ladapn/wallckr-z2/kicad/motherboard/motherboard.kicad_pcb

## KiCad design kicad/motherboard/motherboard.kicad_pcb (2026-10-02)

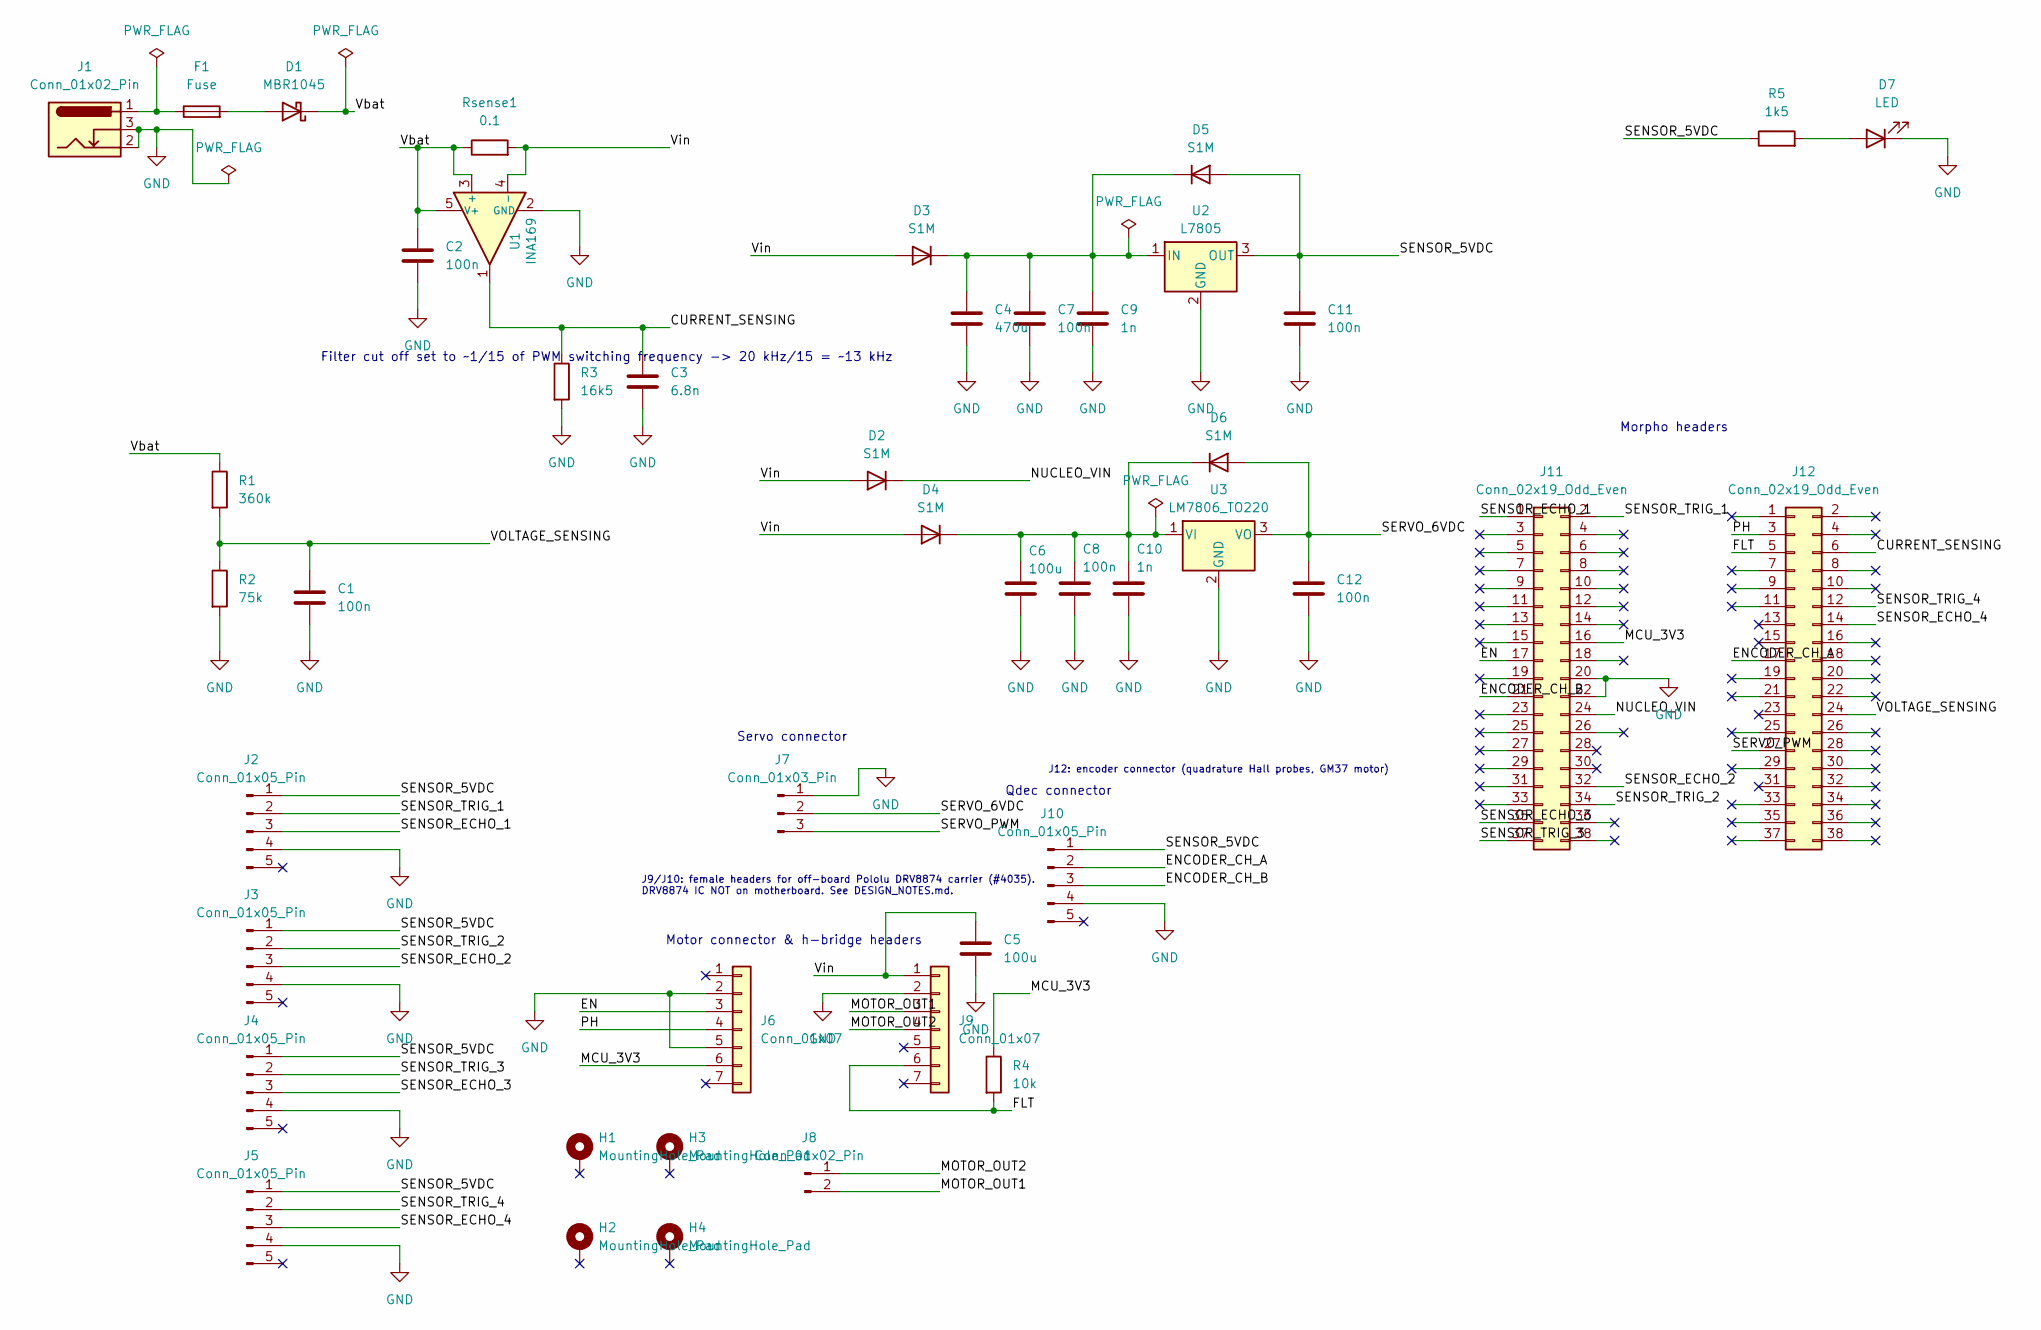
[picture p1: schematic motherboard.kicad_sch]

Parts:
C1, C2, C7, C8, C11, C12: 100n; C_0805_2012Metric_Pad1.18x1.45mm_HandSolder
C3: 6.8n; C_0805_2012Metric_Pad1.18x1.45mm_HandSolder
C4: 470u; CP_Radial_D10.0mm_P5.00mm
C5, C6: 100u; CP_Radial_D6.3mm_P2.50mm
C9, C10: 1n; C_0805_2012Metric_Pad1.18x1.45mm_HandSolder
D1: MBR1045; TO-220-2_Vertical
D2, D3, D4, D5, D6: S1M; D_SMA_Handsoldering
D7: LED; LED_D5.0mm
F1: Fuse; Fuseholder_Cylinder-5x20mm_Stelvio-Kontek_PTF78_Horizontal_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
H1, H2, H3, H4: MountingHole_Pad; MountingHole_3.7mm_Pad_TopBottom
J1: Conn_01x02_Pin; BarrelJack_Horizontal
J2, J3, J4, J5: Conn_01x05_Pin; Molex_KK-254_AE-6410-05A_1x05_P2.54mm_Vertical
J6, J9: Conn_01x07; PinSocket_1x07_P2.54mm_Vertical
J7: Conn_01x03_Pin; Molex_KK-254_AE-6410-03A_1x03_P2.54mm_Vertical
J8: Conn_01x02_Pin; Molex_KK-396_A-41792-0002_1x02_P3.96mm_Horizontal
J10: Conn_01x05_Pin; PinHeader_1x05_P2.54mm_Horizontal
J11, J12: Conn_02x19_Odd_Even; PinSocket_2x19_P2.54mm_Vertical_MirroredPins
R1: 360k; R_0805_2012Metric_Pad1.20x1.40mm_HandSolder
R2: 75k; R_0805_2012Metric_Pad1.20x1.40mm_HandSolder
R3: 16k5; R_0805_2012Metric_Pad1.20x1.40mm_HandSolder
R4: 10k; R_0805_2012Metric_Pad1.20x1.40mm_HandSolder
R5: 1k5; R_0805_2012Metric_Pad1.20x1.40mm_HandSolder
Rsense1: 0.1; R_Axial_DIN0922_L20.0mm_D9.0mm_P25.40mm_Horizontal
U1: INA169; SOT-23-5
U2: L7805; TO-220-3_Vertical
U3: LM7806_TO220; TO-220-3_Vertical

Connections:
/CURRENT_SENSING: C3.1, J12.6, R3.1, U1.1
/EN: J6.3, J11.17
/ENCODER_CH_A: J10.2, J12.17
/ENCODER_CH_B: J10.3, J11.21
/FLT: J9.6, J12.5, R4.2
/MCU_3V3: J6.6, J11.16, R4.1
/MOTOR_OUT1: J8.2, J9.3
/MOTOR_OUT2: J8.1, J9.4
/NUCLEO_VIN: D2.1 (K), J11.24
/PH: J6.4, J12.3
/SENSOR_5VDC: C11.1, D5.2 (A), J2.1, J3.1, J4.1, J5.1, J10.1, R5.1, U2.3 (OUT)
/SENSOR_ECHO_1: J2.3, J11.1
/SENSOR_ECHO_2: J3.3, J11.32
/SENSOR_ECHO_3: J4.3, J11.35
/SENSOR_ECHO_4: J5.3, J12.14
/SENSOR_TRIG_1: J2.2, J11.2
/SENSOR_TRIG_2: J3.2, J11.34
/SENSOR_TRIG_3: J4.2, J11.37
/SENSOR_TRIG_4: J5.2, J12.12
/SERVO_6VDC: C12.1, D6.2 (A), J7.2, U3.3 (VO)
/SERVO_PWM: J7.3, J12.27
/VOLTAGE_SENSING: C1.1, J12.24, R1.2, R2.1
/Vbat: C2.1, D1.1 (K), R1.1, Rsense1.1, U1.3 (+), U1.5 (V+)
/Vin: C5.1, D2.2 (A), D3.2 (A), D4.2 (A), J9.1, Rsense1.2, U1.4 (-)
GND: C1.2, C2.2, C3.2, C4.2, C5.2, C6.2, C7.2, C8.2, C9.2, C10.2, C11.2, C12.2, D7.1 (K), J1.2, J1.3, J2.4, J3.4, J4.4, J5.4, J6.2, J6.5, J7.1, J9.2, J10.4, J11.20, J11.22, R2.2, R3.2, U1.2 (GND), U2.2 (GND), U3.2 (GND)
unnamed: D1.2 (A), F1.2
unnamed: C4.1, C7.1, C9.1, D3.1 (K), D5.1 (K), U2.1 (IN)
unnamed: C6.1, C8.1, C10.1, D4.1 (K), D6.1 (K), U3.1 (VI)
unnamed: D7.2 (A), R5.2
unnamed: F1.1, J1.1

Notes on the sheet:
Filter cut off set to ~1/15 of PWM switching frequency -> 20 kHz/15 = ~13 kHz
J12: encoder connector (quadrature Hall probes, GM37 motor)
Servo connector
J9/J10: female headers for off-board Pololu DRV8874 carrier (#4035). DRV8874 IC NOT on motherboard. See DESIGN_NOTES.md.
Qdec connector
Morpho headers
Motor connector & h-bridge headers

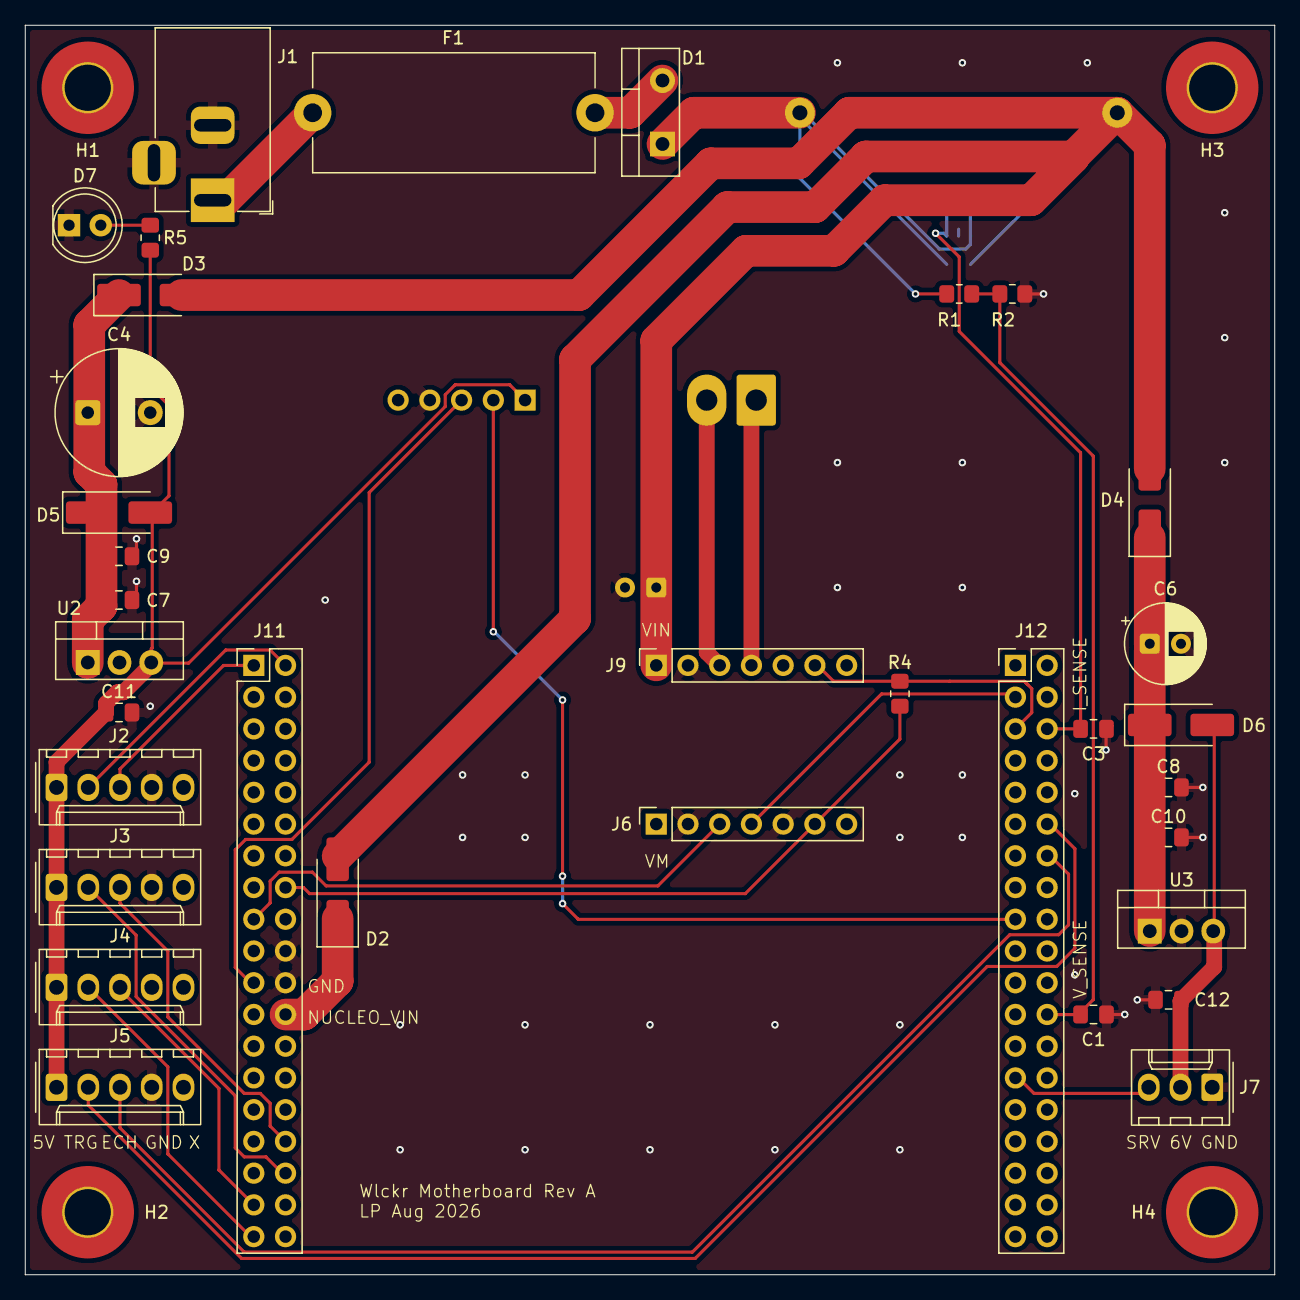
[picture p2: board motherboard.kicad_pcb from above]

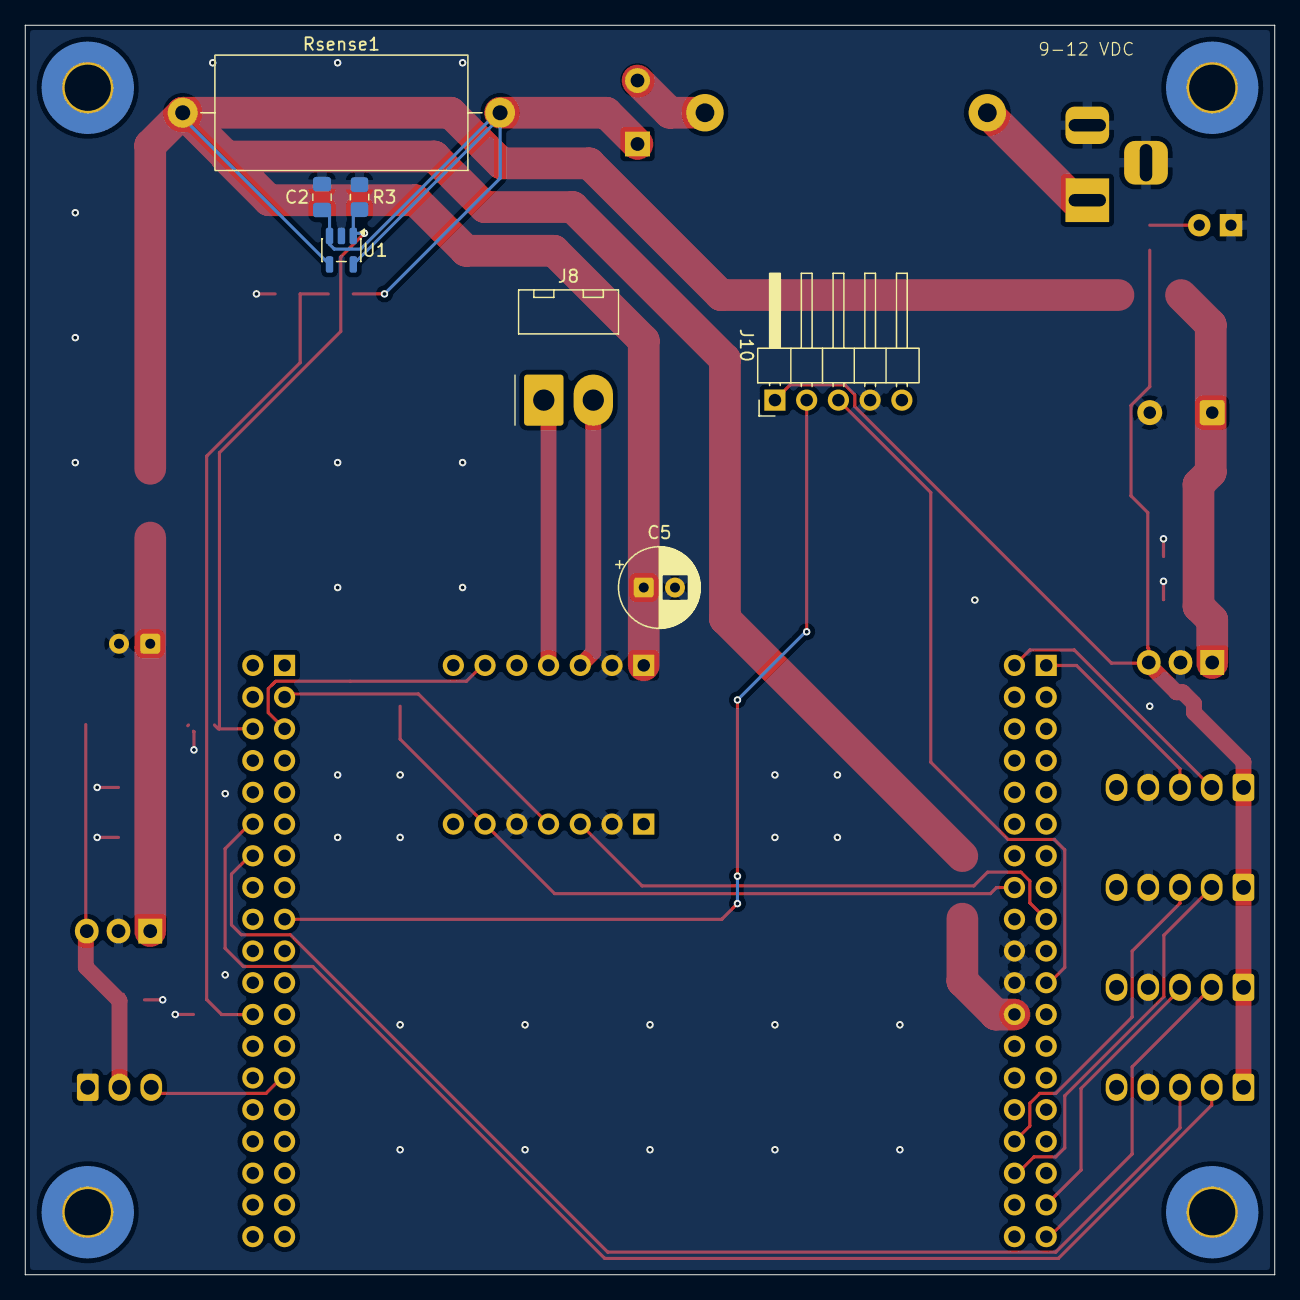
[picture p3: board motherboard.kicad_pcb from below]

Board: 2 copper layers, 100.0 x 100.0 mm, 45 parts (7 on the bottom side), 30 nets.
