ladapn/wallckr-z2/(commit log)

2026-10-02 Add initial files (#1)
    This change adds the following initial files:
    - Kicad project for robot motherboard
    - Instructions for Claude Code
    - Design notes document
    - Configs for clang format and tidy
    [motherboard-B_Cu.gbl, motherboard-B_Mask.gbs, motherboard-B_Paste.gbp, motherboard-B_Silkscreen.gbo, motherboard-Edge_Cuts.gm1, motherboard-F_Cu.gtl, motherboard-F_Mask.gts, motherboard-F_Paste.gtp]
2026-10-05 Add west workspace, shields and bring-up firmware (#2)
    - west.yml pins Zephyr v4.4.2 (latest stable) plus ETL 20.49.0;
    zephyr/module.yml exposes firmware/ as board_root and dts_root.
    - motherboard_shield: motor (PH/EN, DRV8874), steering servo, four
    HY-SRF05 sensors, battery voltage and motor current ADC channels,
    TIM4 quadrature encoder. Pins follow the KiCad PCB; board defaults
    that collide with them (USART1, I2C1, PA0 ADC, TIM2 PWM LED) are
    disabled or re-routed.
    - buttonled_shield: three status LEDs and two buttons (gpio-keys);
    disables SPI2 and the Nucleo B1 button, whose EXTI line clashes
    with Button 1.
    - firmware/bringup: shell-driven bring-up app, C++23 on the minimal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
    [pwm-servo.yaml, wallckr,ph-en-motor.yaml]
2026-10-08 Add CI: formatting, board build and clang-tidy (#4)
    Adds the CI gates from CLAUDE.md that apply today. Runs on
    `pull_request` on `ubuntu-26.04`, like v1's workflow.
    ## Jobs
    - **Code formatting:** clang-format 22.1.5 `--dry-run -Werror` over
    every `.cpp`/`.h` under `firmware/`.
    - **Build and static analysis** (one job per app; only `bringup` for
    now):
    - sets up the west workspace from `west.yml` and the Zephyr SDK (ARM
    toolchain only, cached) via the official
    `zephyrproject-rtos/action-zephyr-setup`;
    - `west build` for `nucleo_f401re` with all three shields;
    - clang-tidy against that build's `compile_commands.json`, so it sees
    the real Zephyr includes and defines.
    ## `tools/clang_tidy.py`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
2026-10-08 Compute current-sense divisor in 64 bit (#5)
    One-line fix in `firmware/bringup/src/analog.cpp`.
    `current_ma()` multiplied Rsense × gain multiplier (`100 * 33`) as `int`
    before the result was widened to `int64_t`, which clang-tidy flags as
    `bugprone-implicit-widening-of-multiplication-result`. The values can't
    overflow today, but the numerator is already computed in 64 bits, so the
    divisor now is too.
    ## Why CI didn't catch it
    Both operands come from Zephyr's `DT_PROP` macro. `tools/clang_tidy.py`
    passes Zephyr's headers as system includes, so clang-tidy treats code
    expanded from Zephyr macros as third-party and stays quiet. That's
    deliberate: it suppresses the noise from `LOG_*`/`SHELL_*`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
    [analog.cpp]
2026-10-08 docs: add git workflow rules to CLAUDE.md (#6)
    Adds a **Git workflow** section to `CLAUDE.md`:
    - **Commit messages** follow [Conventional
    Commits](https://www.conventionalcommits.org/): `<type>(<optional
    scope>): <description>`. It lists the allowed types, suggested scopes
    for this repo (`bringup`, `main`, `lib`, `shields`, `tests`, `ci`,
    `tools`, `docs`, `kicad`), and how to mark breaking changes. PRs are
    squash-merged, so the PR title is the commit that lands on `main` and
    follows the same format.
    - **One element per PR:** a single feature, fix, refactor or docs change
    whenever possible. Unrelated findings go into their own PR, and a change
    that can't be split says why in its description.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
2026-10-09 feat(bringup): add BLE link test (#7)
    Adds a minimal BLE test to the bring-up firmware, to check that the BLE
    link survives while the motor, servo and other peripherals are running.
    ## What it does (`firmware/bringup/src/ble.cpp`)
    Based on Zephyr's `peripheral_nus` sample:
    - Advertises as `wallckr-bringup` with the Nordic UART Service, which
    phone apps such as nRF Connect or Bluetooth serial-terminal apps can
    talk to.
    - Once the phone enables notifications, sends `tick <n>` every second. A
    gap in the numbers means lost notifications.
    - Logs anything the phone writes to the console.
    - Logs every disconnect with its HCI reason, e.g. `Supervision Timeout`,
    and restarts advertising.
    - New shell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
2026-10-13 docs: note Nucleo-L476RG as plan B (#8)
    Adds a short entry under **Known Open Items** in `docs/DESIGN_NOTES.md`
    recording the Nucleo-L476RG as a possible replacement for the F401RE:
    - **Why switch:**
    - the F401 has no hardware RNG, which BLE pairing and encryption need;
    - its flash only allows 128 KB MCUboot swap slots, and a BLE
    firmware-update sample alone (~134 KB, measured) already overflows one.
    - **Motherboard:** no PCB change needed. The connectors match, and the
    timer, SPI and ADC functions are on the same pins.
    - **Only loss:** the Sensor 4 USART6 option, which reused J5 with no
    hardware change. The L476's UART5 is on PC12/PD2 (J11/3, J11/4), which
    aren't connected on the current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
2026-10-13 docs: refine the v1 porting plan (#9)
    Updates `CLAUDE.md` (and two lines of `docs/DESIGN_NOTES.md`) after
    reviewing the porting plan against v1's actual code and the ovladacka
    repo.
    ## Corrections
    - **Seven interfaces, not six.** v1's `Battery` also takes an
    `ICurrentSensor`, implemented in `lib/BatteryArduino`. v1's PORTING.md
    has since been updated to list it too (ladapn/wallckr#53).
    - **Ultrasonic timeout.** The Zephyr `IDistanceSensor` must stop waiting
    at v1's 200 cm limit (~12 ms), not the bring-up tool's 40 ms. Three
    sensors are read every 100 ms.
    - **Formatting.** v1 is formatted in a 2-space LLVM-like style, so the
    port lands as a verbatim copy followed by a reformat-only commit. T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
2026-10-15 docs: add the porting plan (#10)
    Adds `docs/PORTING_PLAN.md`: the order of work for porting v1 to
    `firmware/main`, one PR per step, with a checkbox to tick off as each
    one merges, plus the decisions taken for it. `CLAUDE.md`'s "Read first"
    list now points to it.
    ## Steps
    1. Import v1's target-independent library with its Ztest suites and a
    Twister CI job.
    2. The `firmware/main` skeleton. CI builds it, and clang-tidy is
    extended to `firmware/lib`.
    3–7. One PR per adapter: motor and servo, ultrasonic, battery and
    current, status LEDs, NUS stream.
    8. Wire everything into `Robot` with the control thread; first hardware
    check.
    ## Decisions recorded
    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
2026-10-15 docs: note the motor running while the MCU is in reset (#11)
    Records a bring-up finding in `docs/DESIGN_NOTES.md`. The motor spins in
    two cases: while the Nucleo's reset button is held, and for a few
    seconds after a battery-only power-up. It doesn't happen with USB
    connected.
    ## Cause
    - After reset, PA15 (motor EN) is the JTAG JTDI pin with its internal
    pull-up on. The DRV8874's pull-down on EN is weaker, so EN reads high
    and the motor runs at full speed until the PWM driver claims the pin.
    - On a battery-only power-up this lasts seconds. `nucleo_f401re` clocks
    the MCU from the ST-LINK's 8 MHz output, and clock setup waits for it
    before any driver runs.
    - The same happens during `west flash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
2026-10-15 feat(lib): import v1's target-independent library (#12)
    Step 1 of `docs/PORTING_PLAN.md`: brings v1's target-independent code
    into `firmware/lib/`, with its unit tests running on native_sim in CI.
    ## Commits (review them one at a time)
    1. **Verbatim copy** of v1's `lib/Battery`, `Communication`, `Control`,
    `IOStream`, `Motion`, `Robot`, `Sensing` and `Telemetry` from
    ladapn/wallckr 7099f7f. `TimeManager.h` is left out, because the control
    thread replaces it.
    2. **Reformat only** to the WebKit style. No includes were reordered.
    3. **Build setup:** first a `lib.cmake` include file, then replaced in
    the last commit (see 8).
    4. **Firmware version:** `StatusPacket::version_ID` now comes from the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
2026-10-15 feat(main): add the vehicle firmware skeleton (#14)
    Step 2 of `docs/PORTING_PLAN.md`: adds `firmware/main`, builds it in CI,
    and extends clang-tidy to `firmware/lib`.
    ## Commits
    1. **`firmware/main` skeleton:** a `main.cpp` that boots and logs its
    version, and links `firmware/lib`. Also adds:
    - `prj.conf`: C++23 on the minimal libcpp, ETL, GPIO, PWM, ADC, and a
    Nordic UART Service peripheral advertising as `wallckr`;
    - `VERSION`, starting at 0.1.0, so `StatusPacket` will report
    `0x00010000`.
    2. **clang-tidy fixes in `firmware/lib`.** CLAUDE.md allows small
    behavior-neutral fixes to the imported library, and these are all of
    them:
    - `uint8_t` base types for the packet-ID enums and `JoystickC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
2026-10-15 feat(main): add the motor and servo adapters (#16)
    Step 3 of `docs/PORTING_PLAN.md`: the Zephyr implementations of
    `IMotorController` and `ISteeringServo`, in `firmware/main/src/`.
    ## `ZephyrMotorController` (DRV8874, PH/EN mode)
    - `set_speed(speed)` with `speed` in [-255, 255]:
    - PH = forward for `speed >= 0`;
    - EN duty = |speed| / `MAX_SPEED` of the 25 kHz period, the same duty as
    v1's `analogWrite(speed)`;
    - out-of-range speeds return `false` and change nothing, as in v1.
    - `stop()` drops the duty to 0 and leaves PH as it is, as v1 did.
    - nFAULT is ignored, as v1 had nothing like it.
    - `init()` configures PH (as an inactive output) and stops the motor. It
    must run before the controll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
2026-10-15 docs: add nFAULT handling to the porting plan's next steps (#17)
    Adds motor driver fault handling to the "After the port" list in
    `docs/PORTING_PLAN.md`.
    The port ignores the DRV8874's nFAULT line (PB9), as v1 had nothing like
    it (step 3, #16). The driver protects itself on overcurrent,
    overtemperature and undervoltage and recovers by itself. The firmware
    only needs nFAULT to report why the motor stopped: in the log, on the
    ERR LED, and/or in telemetry. It's new behavior, so it goes after the
    port, next to closed-loop speed control.
    https://claude.ai/code/session_01E4YCzG84MAQCxkWhwWzfZZ
    ---
    _Generated by [Claude
    Code](htt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
2026-10-16 feat(main): add the ultrasonic distance adapter (#19)
    Step 4 of `docs/PORTING_PLAN.md`: `ZephyrUltrasonicSensor`, the Zephyr
    `IDistanceSensor` for the HY-SRF05.
    ## Behavior (matching v1's NewPing)
    - **Ping:** a 10 µs trigger pulse, then:
    - up to **5.8 ms** for the echo to start (NewPing's `MAX_SENSOR_DELAY`);
    - up to **(max + 1) × 57 + 28 µs** for it to end, which is 11.5 ms for
    200 cm (NewPing's `_maxEchoTime`). The bring-up `sonar` command waits
    out the sensor's ~30 ms out-of-range echo; this adapter doesn't.
    - **Distance:** echo µs / 57, integer, as NewPing's `ping_cm()`. No
    echo, or one that's too long, gives 0, which reads as the maximum
    distance (200 cm), as v1's adapter did.
    - **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
2026-10-16 feat(main): add the battery and current adapters (#20)
    Step 5 of `docs/PORTING_PLAN.md`: `ZephyrBatterySensor`
    (`IBatterySensor`) and `ZephyrCurrentSensor` (`ICurrentSensor`), both in
    `firmware/main/src/ZephyrAnalogSensors.{h,cpp}`. They share one file, as
    v1 kept both in `lib/BatteryArduino`.
    ## Behavior
    - **Battery:**
    - `get_battery_voltage_mVDC()` returns **mV at the ADC pin**, via
    `adc_raw_to_millivolts_dt`. That keeps v1's meaning, so `Battery` and
    its cutoff logic work unchanged; step 9 sets the cutoff for the ÷5
    divider.
    - `get_battery_voltage_adc()` now returns a 12-bit raw value. Only the
    test stubs call it.
    - **Current:** mA = mV × 1000 / (Rsense × gain). Rsense and the gain
    fr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
2026-10-16 feat(main): add the status LED adapter (#21)
    Step 6 of `docs/PORTING_PLAN.md`: `ZephyrRobotIndicators`, the Zephyr
    `IRobotIndicators` on the Button/LED shield.
    ## Behavior (v1's `ArduinoRobotIndicators`)
    - `indicate_robot_state()`:
    - following: STATE1 on, STATE2 off;
    - avoiding: STATE1 off, STATE2 on;
    - idle or error: both off.
    STATE1 is v1's LED1 and STATE2 is v1's LED2.
    - `indicate_battery_warning()` toggles ERR (v1's LED5) on every call.
    `Robot` calls it on each status check while the battery is dead, so it
    blinks at 0.5 Hz, as in v1.
    - `init()` configures all three LEDs as outputs, off.
    ## Design
    - The LEDs are active low (sourced from 3V3, sunk by the GPIO). The
    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
2026-10-16 refactor(lib): use etl::array and etl::span for packets (#22)
    Step 7 of `docs/PORTING_PLAN.md`: packet serialization in `firmware/lib`
    moves to `etl::array` and `etl::span`, ahead of the NUS stream adapter
    (step 8).
    ## Changes
    - **Packets:** `serialize()` now takes a fixed-size `etl::span<uint8_t,
    SERIALIZED_SIZE>` and returns nothing. The compiler checks the buffer
    size, so the per-packet null/size checks and their `bool` results are
    gone. Fields go through a small `PacketWriter`, which replaces the
    pointer-and-offset helpers.
    - **`RobotPrinter::print()`:**
    - builds the packet in an `etl::array`;
    - computes the CRC over all bytes but the last;
    - writes the whole array.
    That removes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
2026-10-19 feat(main): add the NUS command and telemetry stream (#23)
    Step 8 of `docs/PORTING_PLAN.md`: `ZephyrNusStream`, the Zephyr
    `IRobotIOStream` over the Nordic UART Service. It carries both the
    ovladacka command stream and the telemetry.
    - **Receiving:**
    - The NUS receive callback runs in the Bluetooth RX thread, not in an
    interrupt.
    - It copies the bytes into an `etl::circular_buffer` (64 bytes, about 20
    three-byte commands) and posts a command event bit on a `k_event` passed
    to the constructor.
    - The control thread wakes on that event and drains the buffer with
    `available()`/`read()`. `read()` returns −1 when the buffer is empty, as
    Arduino's `Stream::read()` did in v1.
    - A `k_m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
2026-10-19 feat(main): wire the robot and control thread (#24)
    Step 9 of `docs/PORTING_PLAN.md`, the last step of the port. It connects
    the adapters from steps 3–8 to v1's `Robot`, so the vehicle firmware now
    actually runs.
    ## What it does
    - **Object graph:** `main()` builds the same objects as v1's `loop()`,
    as locals. Pins come from the devicetree and the sensors map as in the
    design notes: front = J4 (`ultrasonic3`), right front = J3
    (`ultrasonic2`), right = J2 (`ultrasonic1`).
    - **Control thread:** the main thread is the control thread. It waits
    with `k_event_wait_safe` on TICK (a 100 ms `k_timer`, first expiry right
    away) or COMMAND (posted by the NUS stream). The safe variant clears the
    bits i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
2026-10-20 docs: record the servo twitch on reset release and its pull-down (#27)
    Records the bring-up finding that the servo twitches when the MCU leaves
    reset, and the 10 kΩ pull-down that fixed it on the bench. It goes next
    to the motor-in-reset entry (PA15) in `docs/DESIGN_NOTES.md`.
    - **The pull-up:** after reset, PB4 is the JTAG NJTRST pin with its
    internal pull-up enabled. So the servo line stays high through reset and
    boot, until the PWM driver claims the pin and drives it low.
    - **The twitch:** the servo sees that as one pulse far longer than its
    2400 µs maximum and kicks toward that end.
    - **Why nothing happens while reset is held:** a steady high level has
    no falling edge.
    ## Ch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
2026-10-22 feat(shields): count encoder edges on both channels (#28)
    Configures the TIM4 quadrature decoder in `motherboard_shield.overlay`
    for the real encoder.
    - **`st,encoder-mode = <3>`:** x4. The timer counts both edges of both
    channels, where the driver's default (mode 1, x2) counted only channel
    A's edges. This doubles the resolution, which matters most for low-speed
    estimates in the planned closed-loop speed control. It costs nothing at
    runtime, since the timer counts in hardware.
    - **`st,counts-per-revolution = <380>`:** counts per gearbox output
    revolution, replacing the placeholder 4. That's 20 counts per motor
    revolution at x4, times the 19:1 gearbox.
    ## Notes
    - **Overflow:** T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
2026-11-06 build: update Zephyr to v4.5.0 (#29)
    Moves the `west.yml` pin from v4.4.2 to v4.5.0, the latest stable
    release; there's no 4.5.x patch release yet.
    - **`west.yml`:** `revision: v4.5.0`. The module allowlist is unchanged,
    and all four modules still resolve.
    - **`firmware/main/src/main.cpp`:** includes `<zephyr/app_version.h>`
    instead of `<app_version.h>`. 4.5 disables
    `CONFIG_LEGACY_GENERATED_INCLUDE_PATH`, so generated headers need the
    `zephyr/` prefix. It was the only such include in the repo.
    - **`CLAUDE.md`, `docs/DESIGN_NOTES.md`:** the pinned version now reads
    v4.5.0.
    The SDK stays at 1.0.1, which is what 4.5's `SDK_VERSION` asks for. CI
    needs no changes: 4.5 raises the min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
2026-11-13 feat(bringup): add a motor step-response command (#31)
    Step 1 of the closed-loop motor control plan (#30). This adds a bring-up
    command that measures the motor's response, to collect the data for
    tuning the speed loop during the hardware test.
    ## `motor step <duty> <ms>`
    - **What it does:** applies a PWM step (−255…255) for 10–5000 ms, then
    stops the motor.
    - **Sampling:** samples the encoder every 10 ms. The timing uses
    absolute timeouts, so it doesn't drift, and the output is printed only
    after the motor has stopped, so the UART doesn't add jitter.
    - **Wrap:** samples are unwrapped across the counter's wrap. The qdec
    driver counts 0–65,359, so differences are taken modulo 65,360,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
2026-11-13 docs: add the closed-loop motor control plan (#30)
    Adds `docs/MOTOR_CONTROL_PLAN.md`, the plan for the first feature after
    the port: closed-loop speed control using the encoder. The "After the
    port" bullet in `docs/PORTING_PLAN.md` now points to it.
    - **No change to `Robot` or `Motion`:** the loop closes below
    `IMotorController`.
    - `IWheelEncoder`, new in `lib`, reports the counts moved since the last
    read.
    - `ClosedLoopMotorController`, new in `lib`, wraps the open-loop motor
    controller. `set_speed()` stores the target, and `update()` runs a PI
    loop once per tick.
    - `stop()` zeroes the target, the duty and the integrator, so a battery
    cutoff still stops the motor at once.
    - **Ant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
